yinhaoqian/PilotRadarsInterface/Enclosure/VDM-22.JPG

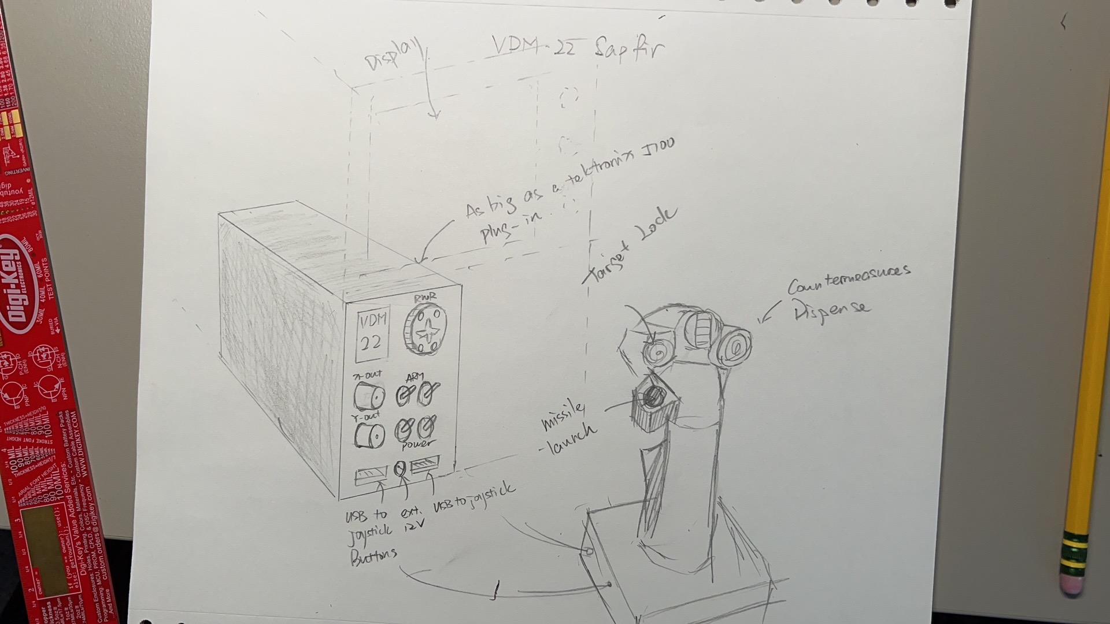
Enclosure/VDM-22.JPG
