yinhaoqian/PilotRadarsInterface/Readme.txt

+---Enclosure - all files related to enclosure design
|   \---svgs - vectors used
+---Hardware - all files related to hardware design
|   +---Library - all libraries used for hardware
|   +---Output  - generated output from Altium designer
|   \---VDM-22 - project folder openable by Altium Designer
|       +---Project Logs for VDM-22  - Altium auto generated log files 
|       \---Project Outputs for VDM-22 - Altium auto generated output files
\---Software - project folder openable by Arduino IDE
    \---qt_lib - project folder openable by QT Creator
